PairZhu/Paper-Lamp/展示/斜侧面.jpg

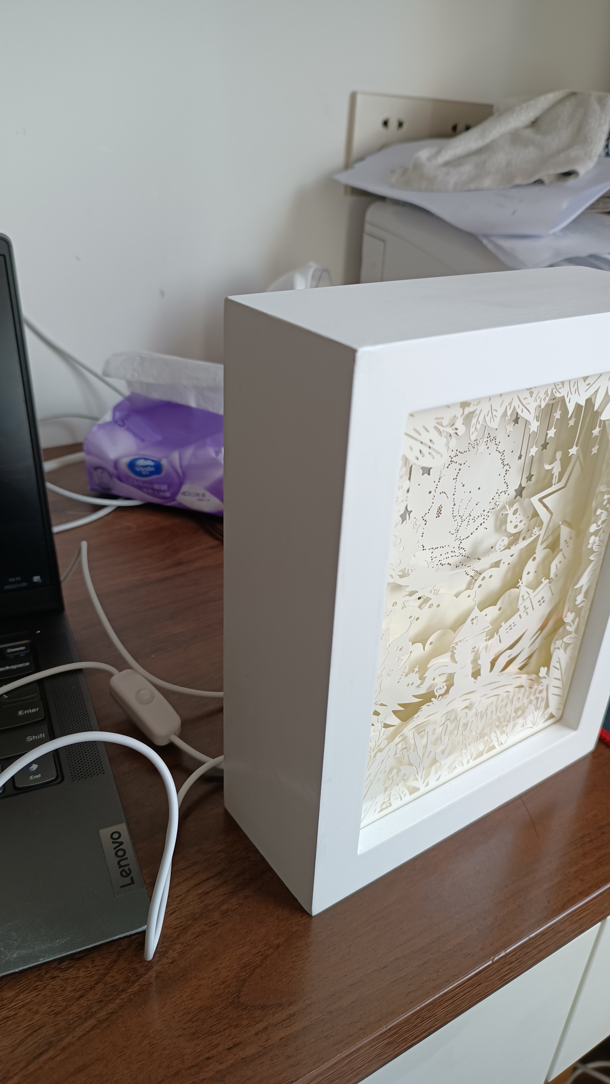
展示/斜侧面.jpg
