PairZhu/Paper-Lamp/纸雕灯控制小程序/img/color.png

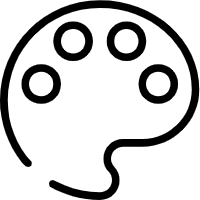
纸雕灯控制小程序/img/color.png
