PairZhu/Paper-Lamp/纸雕灯控制小程序/img/color_fill.png

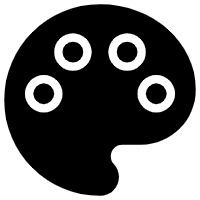
纸雕灯控制小程序/img/color_fill.png
