PairZhu/Paper-Lamp/纸雕灯控制小程序/img/favor_fill.png

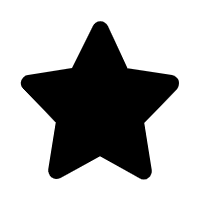
纸雕灯控制小程序/img/favor_fill.png
