PairZhu/Paper-Lamp/纸雕灯控制小程序/img/home_fill.png

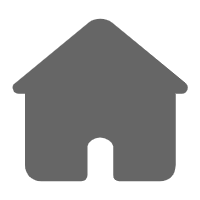
纸雕灯控制小程序/img/home_fill.png
