PairZhu/Paper-Lamp/纸雕灯控制小程序/img/time.png

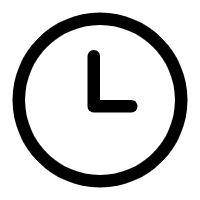
纸雕灯控制小程序/img/time.png
