PairZhu/Paper-Lamp/纸雕灯控制小程序/img/time_fill.png

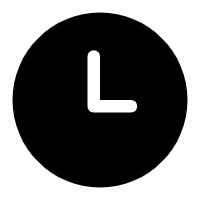
纸雕灯控制小程序/img/time_fill.png
