PairZhu/Paper-Lamp/资料/LGT328P-LQFP32-Nano.pdf

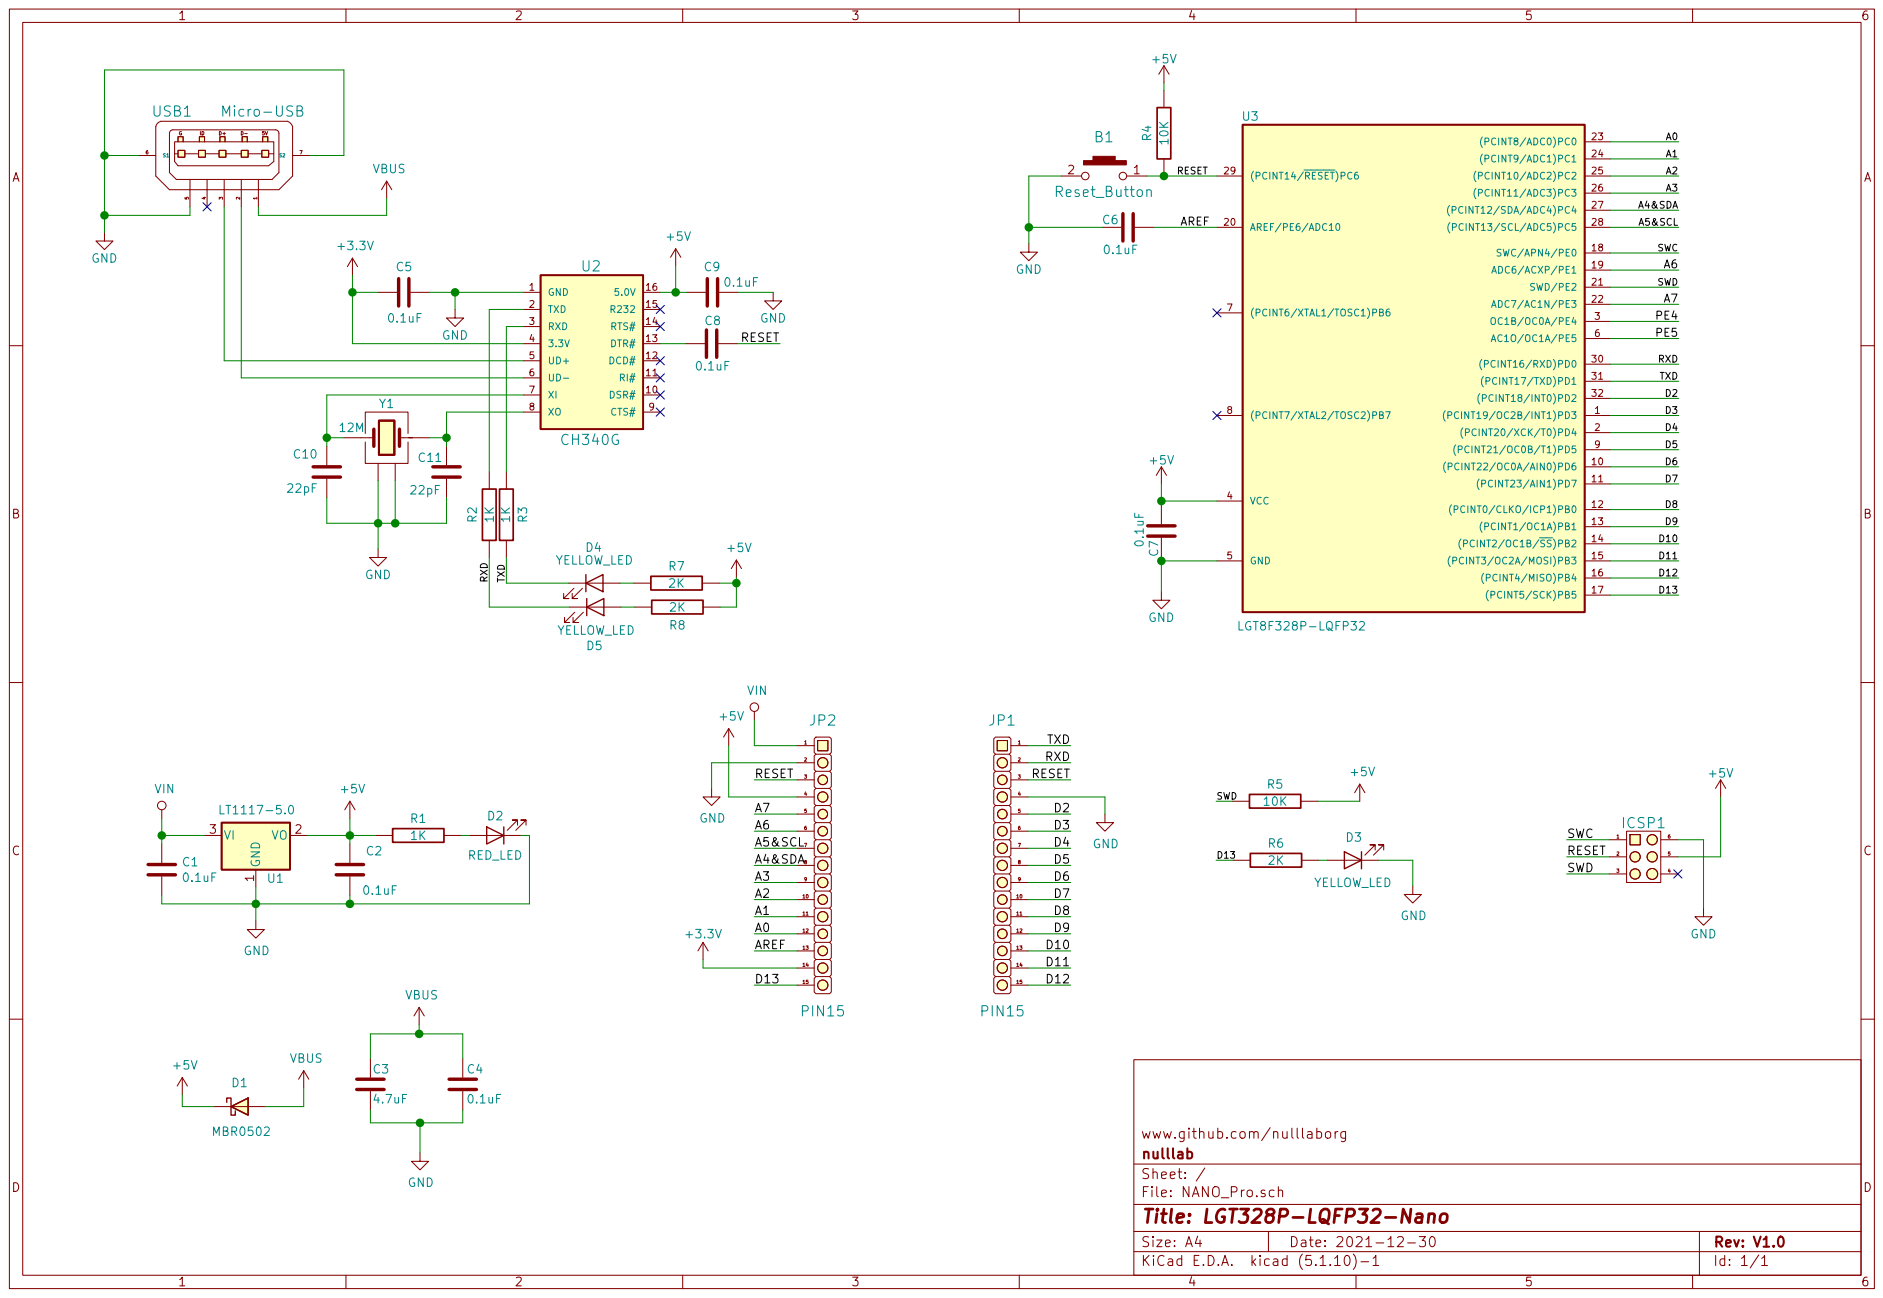
[picture p14: page 1]

File: NANO_Pro.sch Sheet: / nulllab www.github.com/nulllaborg
