PairZhu/Paper-Lamp/(list of files, drawings)

Other design files:
原理图/原理图(仅供查看，不可仿真).pdsprj
